kwiecinski/Dental-Chair-Controller/pictures/PCB-in-case-closed.JPG

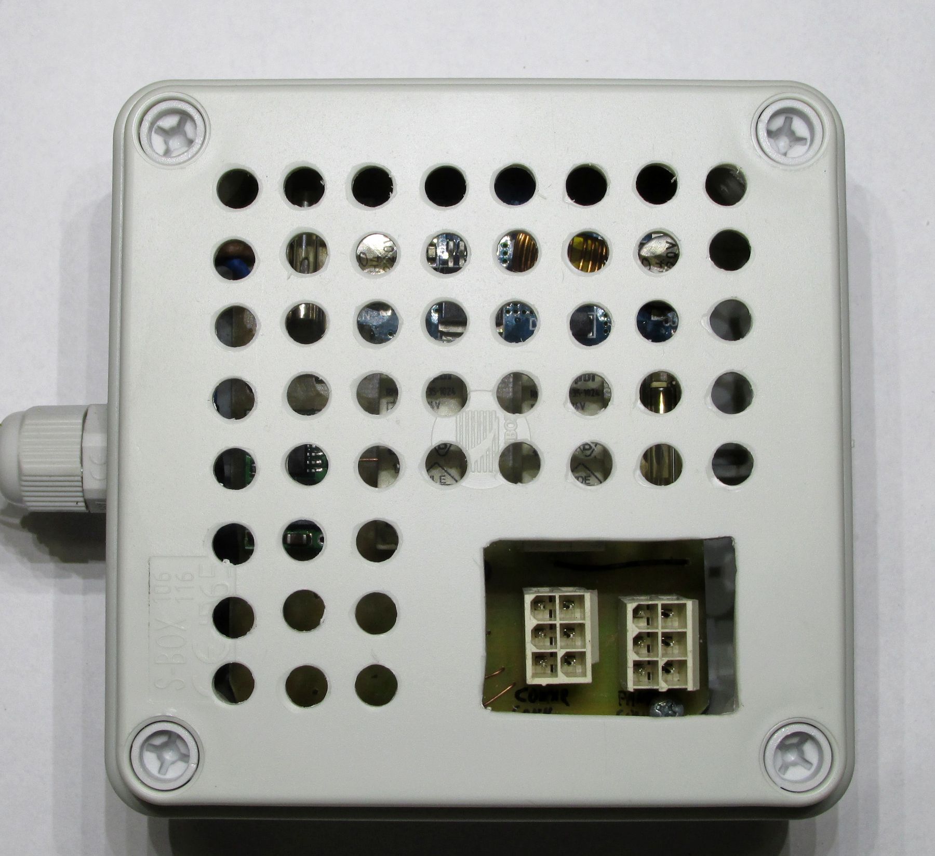
pictures/PCB-in-case-closed.JPG
