kwiecinski/Dental-Chair-Controller/pictures/PCB-in-case-open.JPG

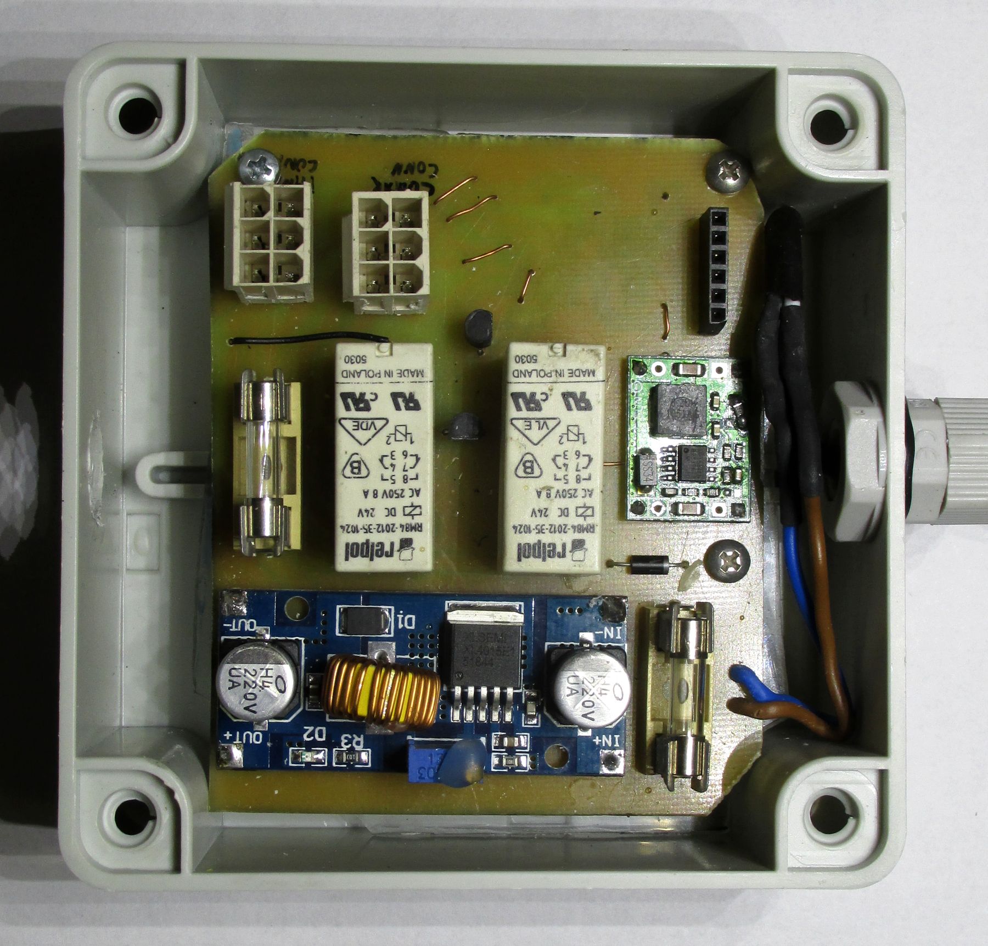
pictures/PCB-in-case-open.JPG
