kwiecinski/Dental-Chair-Controller/README.md

### UP/DOWN controller for dental chair

- PCB: KiCad v5.1.5
- Code build in MPLAB X IDE v5.30, XC8 compiler v2.10 (free version)
