kwiecinski/Dental-Chair-Controller/pictures/Control-panel.JPG

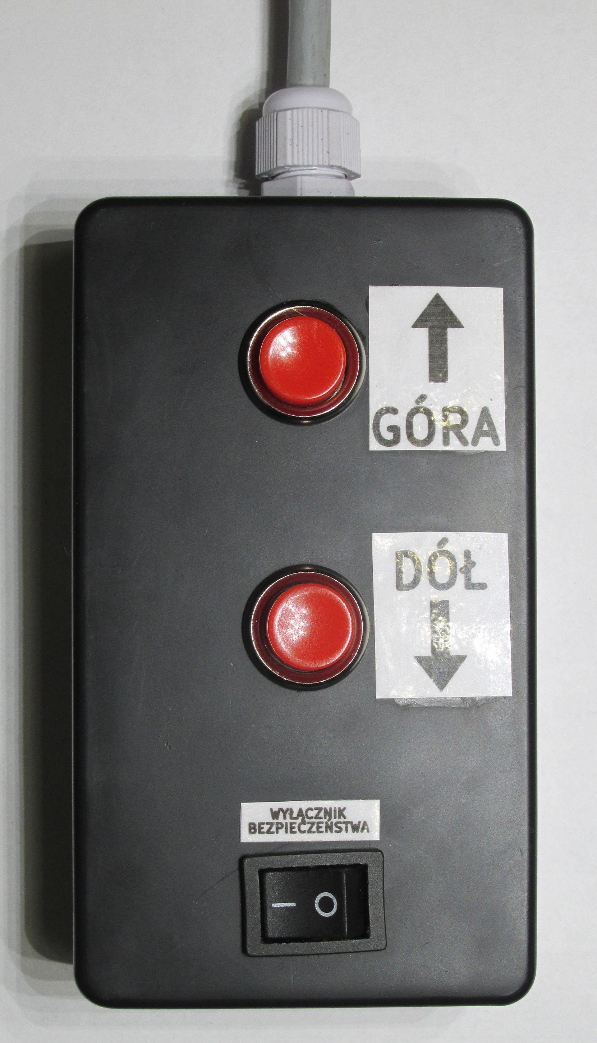
pictures/Control-panel.JPG
