kwiecinski/Dental-Chair-Controller/pictures/PCB-bottom.JPG

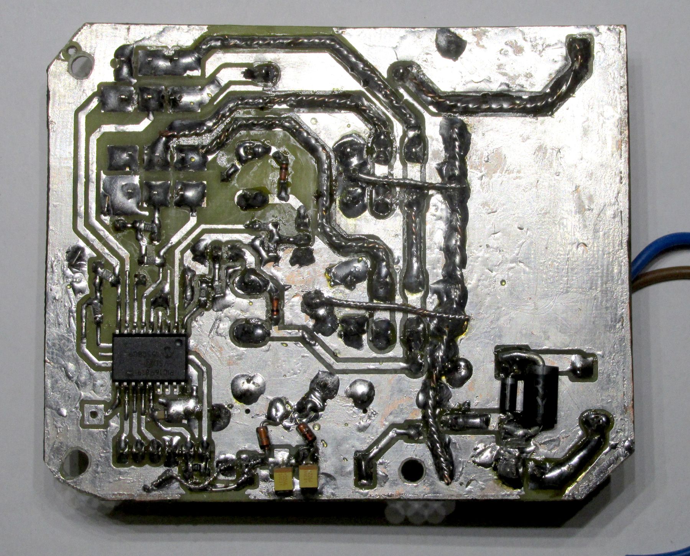
pictures/PCB-bottom.JPG
