kwiecinski/Dental-Chair-Controller/pictures/PCB-top.JPG

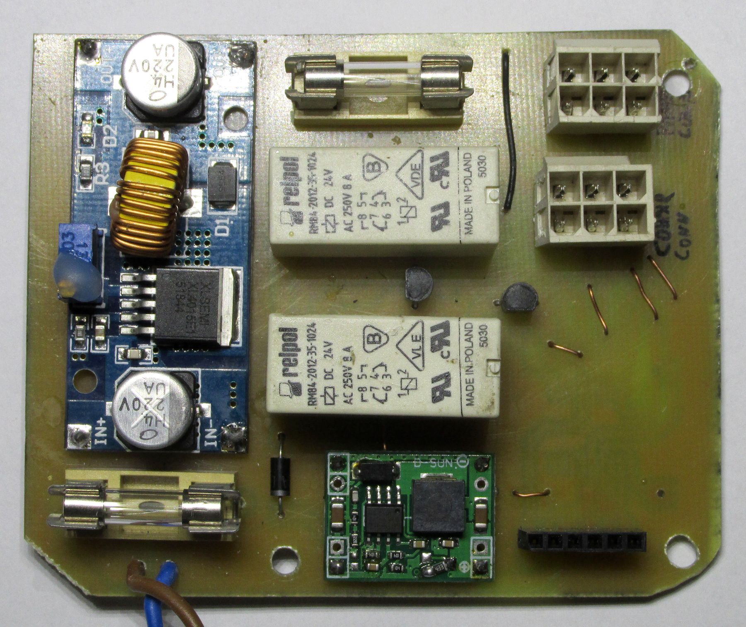
pictures/PCB-top.JPG
