kwiecinski/Dental-Chair-Controller/PCB/dental-chair-controller.kicad_pcb

## KiCad design PCB/dental-chair-controller.kicad_pcb (2020-02-22)

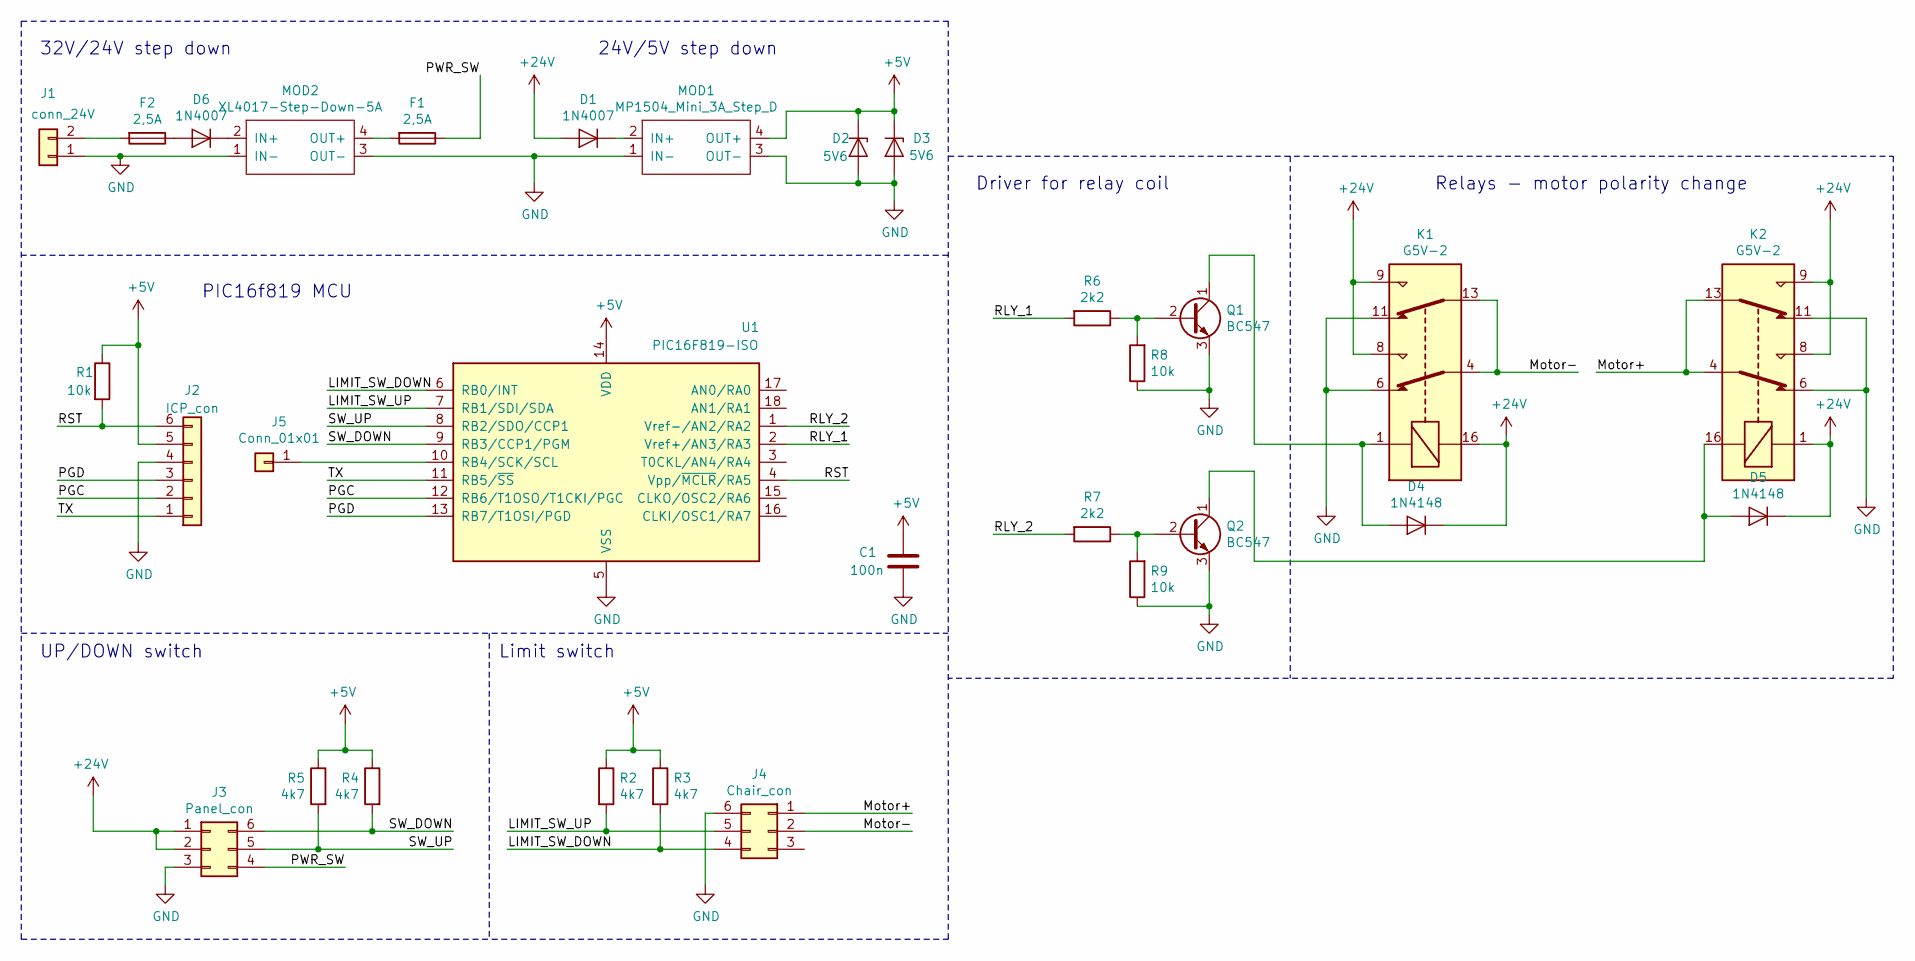
[picture p6: schematic dental-chair-controller.sch]

Parts:
C1: 100n; C_0805_HandSoldering
D1, D6: 1N4007; D_DO-41_SOD81_P10.16mm_Horizontal
D2, D3: 5V6; D_DO-35_SOD27_P7.62mm_Horizontal
D4, D5: 1N4148; R_0805_HandSoldering
F1, F2: 2,5A; Fuseholder5x20_horiz_SemiClosed_Casing10x25mm
J1: conn_24V; Conn_1x2_wire
J2: ICP_con; Pin_Header_Straight_1x06_Pitch2.54mm
J3: Panel_con; Molex_MegaFit_2x03x5.70mm_Straight
J4: Chair_con; Molex_MegaFit_2x03x5.70mm_Straight
J5: Conn_01x01; WIRE_PAD_1,3mm
K1, K2: G5V-2; Relay_29mm
MOD1: MP1504_Mini_3A_Step_D; MP1504_Mini_3A_Step_Down_Conv
MOD2: XL4017-Step-Down-5A
Q1, Q2: BC547; TO-92_Inline_Wide
R1, R8, R9: 10k; R_0805_HandSoldering
R2, R3, R4, R5: 4k7; R_0805_HandSoldering
R6, R7: 2k2; R_0805_HandSoldering
U1: PIC16F819-ISO; SOIC-18W_7.5x11.6mm_Pitch1.27mm

Connections:
+5V: C1.1, D2.1 (K), D3.1 (K), J2.5, MOD1.4 (OUT+), R1.1, R2.1, R3.1, R4.1, R5.1, U1.14 (VDD)
+24V: D1.2 (A), D4.1 (K), D5.1 (K), J3.1, J3.2, K1.8, K1.9, K1.16, K2.1, K2.8, K2.9
/LIMIT_SW_DOWN: J4.4, R3.2, U1.6 (RB0/INT)
/LIMIT_SW_UP: J4.5, R2.2, U1.7 (RB1/SDI/SDA)
/Motor+: J4.1, K2.4, K2.13
/Motor-: J4.2, K1.4, K1.13
/PGC: J2.2, U1.12 (RB6/T1OSO/T1CKI/PGC)
/PGD: J2.3, U1.13 (RB7/T1OSI/PGD)
/PWR_SW: F1.1, J3.4
/RLY_1: R6.2, U1.2 (Vref+/AN3/RA3)
/RLY_2: R7.2, U1.1 (Vref-/AN2/RA2)
/RST: J2.6, R1.2, U1.4 (Vpp/~MCLR~/RA5)
/SW_DOWN: J3.6, R4.2, U1.9 (RB3/CCP1/PGM)
/SW_UP: J3.5, R5.2, U1.8 (RB2/SDO/CCP1)
/TX: J2.1, U1.11 (RB5/~SS~)
GND: C1.2, D2.2 (A), D3.2 (A), J1.1, J2.4, J3.3, J4.6, K1.6, K1.11, K2.6, K2.11, MOD1.1 (IN-), MOD1.3 (OUT-), MOD2.1 (IN-), MOD2.3 (OUT-), Q1.3 (E), Q2.3 (E), R8.1, R9.1, U1.5 (VSS)
unnamed: D1.1 (K), MOD1.2 (IN+)
unnamed: D4.2 (A), K1.1, Q1.1 (C)
unnamed: D5.2 (A), K2.16, Q2.1 (C)
unnamed: D6.1 (K), MOD2.2 (IN+)
unnamed: D6.2 (A), F2.1
unnamed: F1.2, MOD2.4 (OUT+)
unnamed: F2.2, J1.2
unnamed: J5.1, U1.10 (RB4/SCK/SCL)
unnamed: Q1.2 (B), R6.1, R8.2
unnamed: Q2.2 (B), R7.1, R9.2

Notes on the sheet:
Limit switch
UP/DOWN switch
32V/24V step down
24V/5V step down
PIC16f819 MCU
Driver for relay coil
Relays - motor polarity change

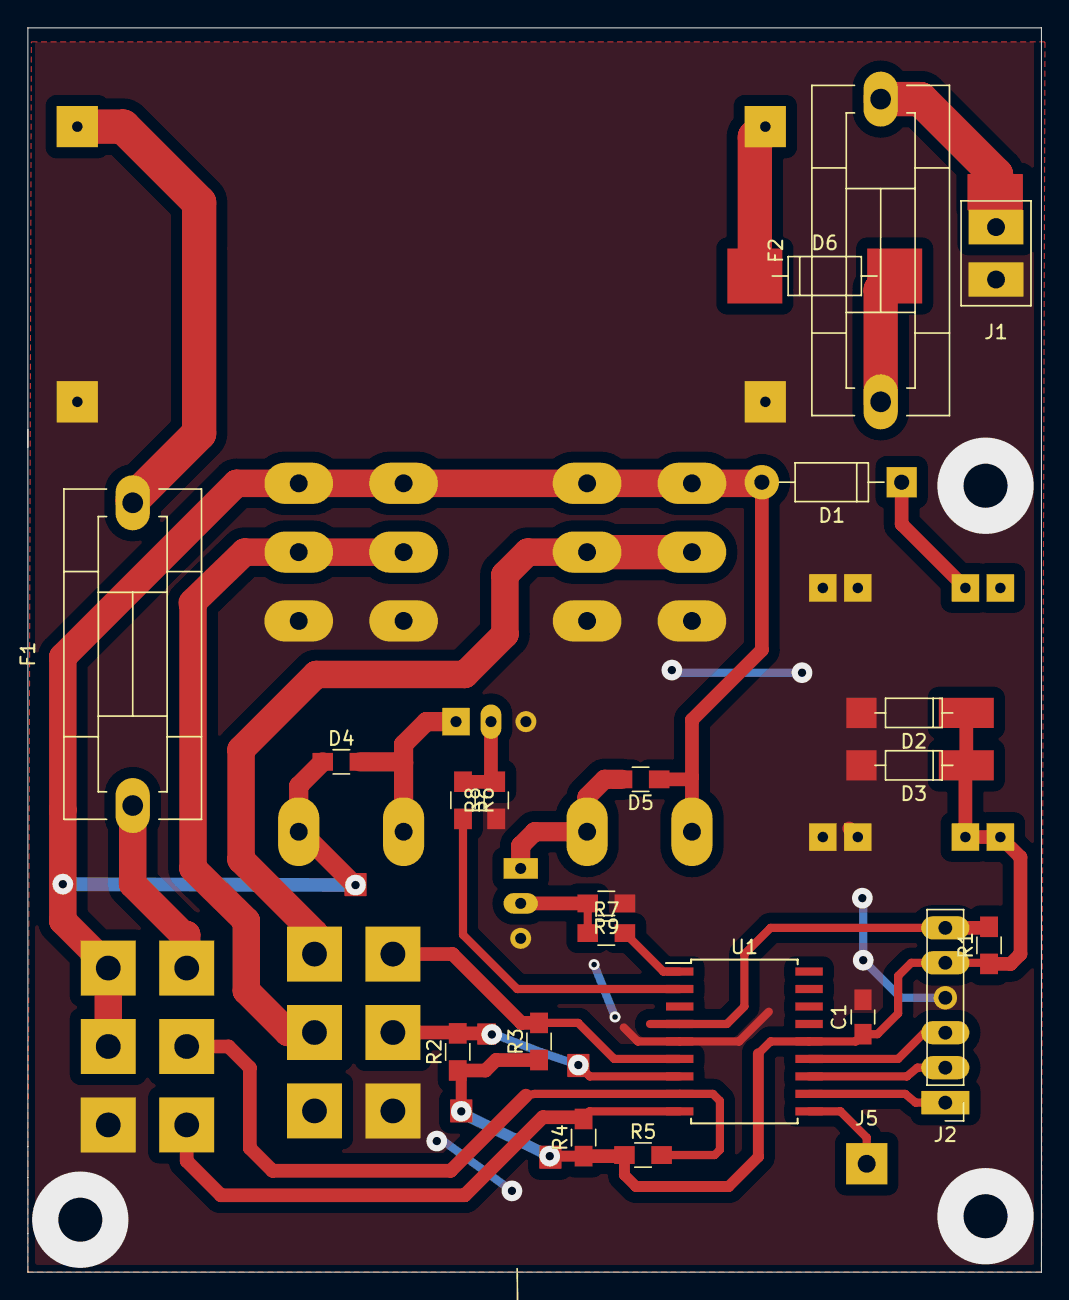
[picture p7: board dental-chair-controller.kicad_pcb from above]

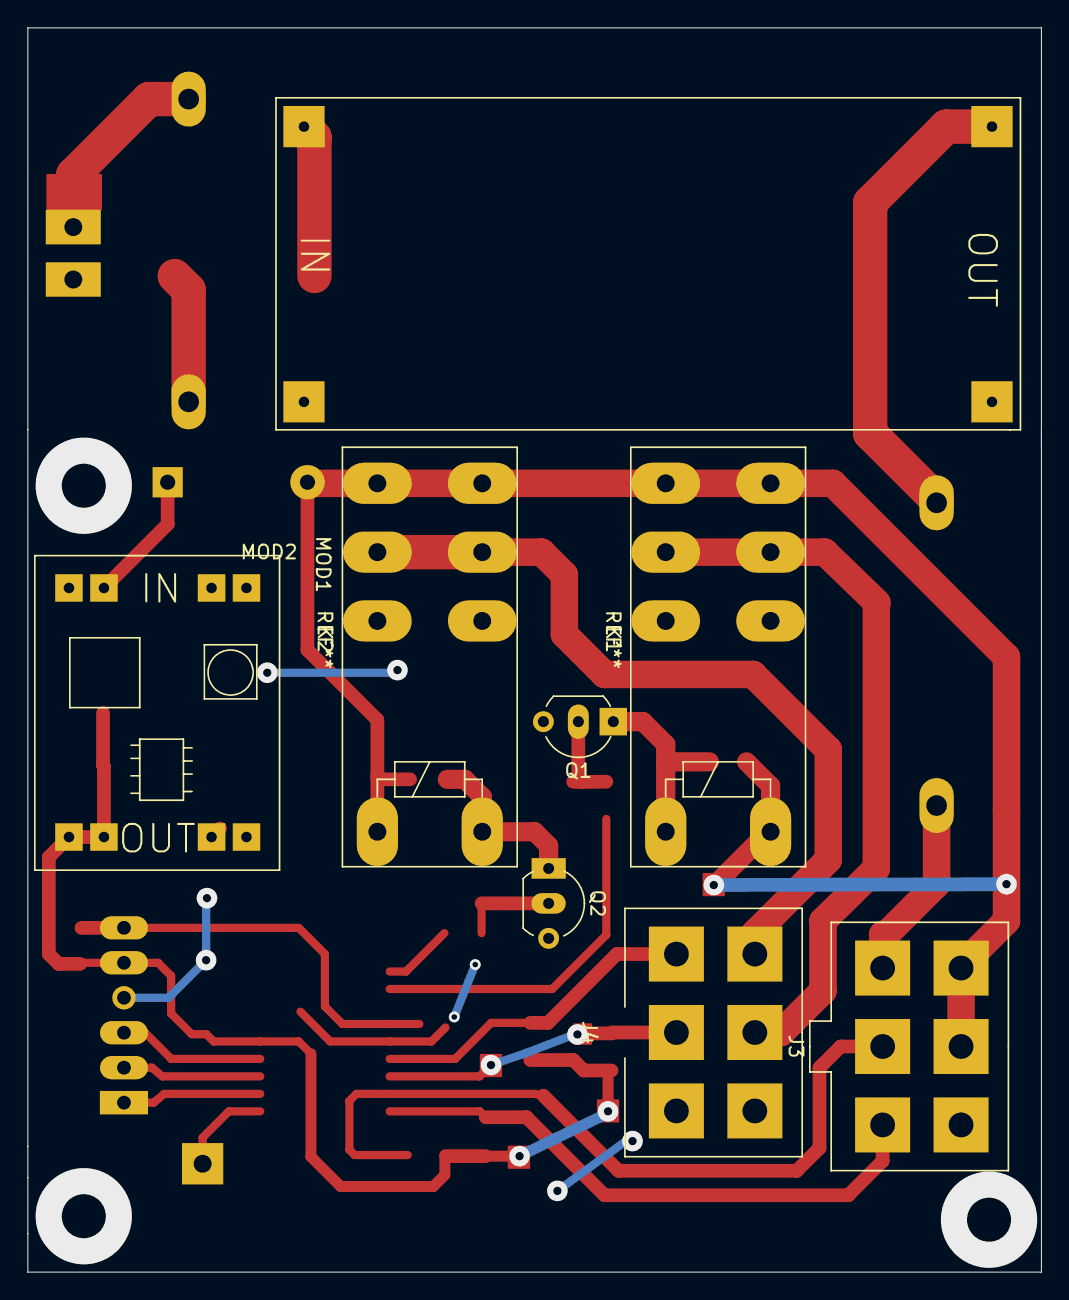
[picture p8: board dental-chair-controller.kicad_pcb from below]

Board: 2 copper layers, 73.7 x 90.4 mm, 30 parts (8 on the bottom side), 26 nets.
