kwiecinski/Dental-Chair-Controller/PIC-code-src/dental-chair-controller.X/define.h

#ifndef XC_HEADER_TEMPLATE_H
#define	XC_HEADER_TEMPLATE_H

#define _XTAL_FREQ 8000000

// PIC16F819 Configuration Bit Settings
// CONFIG
#pragma config FOSC = INTOSCIO  // Oscillator Selection bits (INTRC oscillator; port I/O function on both RA6/OSC2/CLKO pin and RA7/OSC1/CLKI pin)
#pragma config WDTE = ON        // Watchdog Timer Enable bit (WDT enabled)
#pragma config PWRTE = OFF      // Power-up Timer Enable bit (PWRT disabled)
#pragma config MCLRE = ON       // RA5/MCLR/VPP Pin Function Select bit (RA5/MCLR/VPP pin function is MCLR)
#pragma config BOREN = ON       // Brown-out Reset Enable bit (BOR enabled)
#pragma config LVP = OFF        // Low-Voltage Programming Enable bit
#pragma config CPD = OFF        // Data EE Memory Code Protection bit (Code protection off)
#pragma config WRT = OFF        // Flash Program Memory Write Enable bits (Write protection off)
#pragma config CCPMX = RB2      // CCP1 Pin Selection bit (CCP1 function on RB2)
#pragma config CP = OFF         // Flash Program Memory Code Protection bit (Code protection off)


typedef struct
{
    unsigned char down_button, up_button,
                  down_limit_sw, up_limit_sw;
    
}FLAGS;

#endif	/* XC_HEADER_TEMPLATE_H */
